nonesense84/VID_Doppelschaft/Dokumente/Rückansicht.png

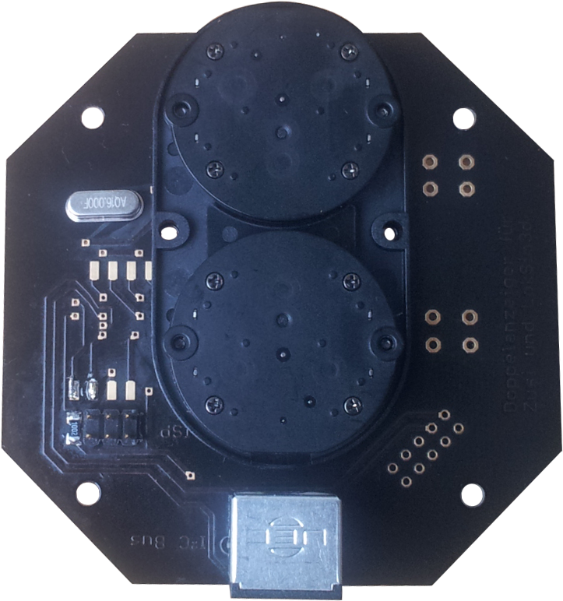
Dokumente/Rückansicht.png
