nonesense84/VID_Doppelschaft/Dokumente/Vorderansicht.png

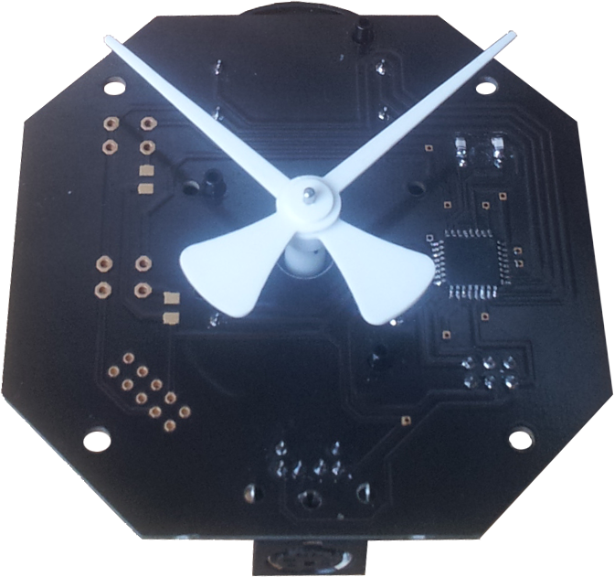
Dokumente/Vorderansicht.png
