nonesense84/VID_Doppelschaft/Dokumente/ProtokollExtrahiert.png

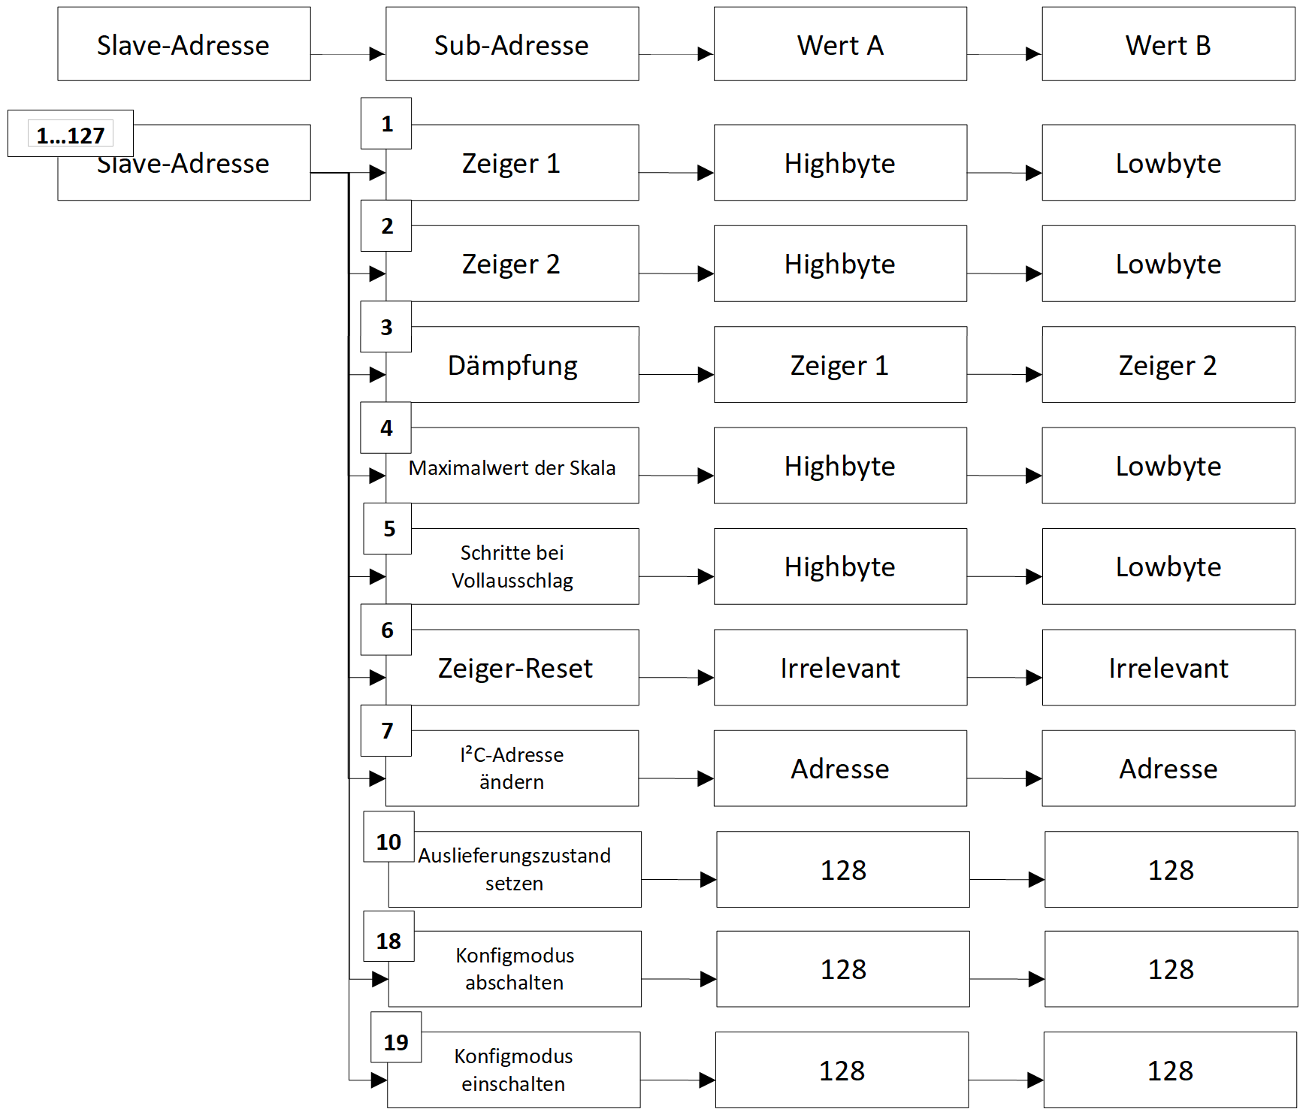
Dokumente/ProtokollExtrahiert.png
