nonesense84/VID_Doppelschaft/Dokumente/Schaltplan2.png

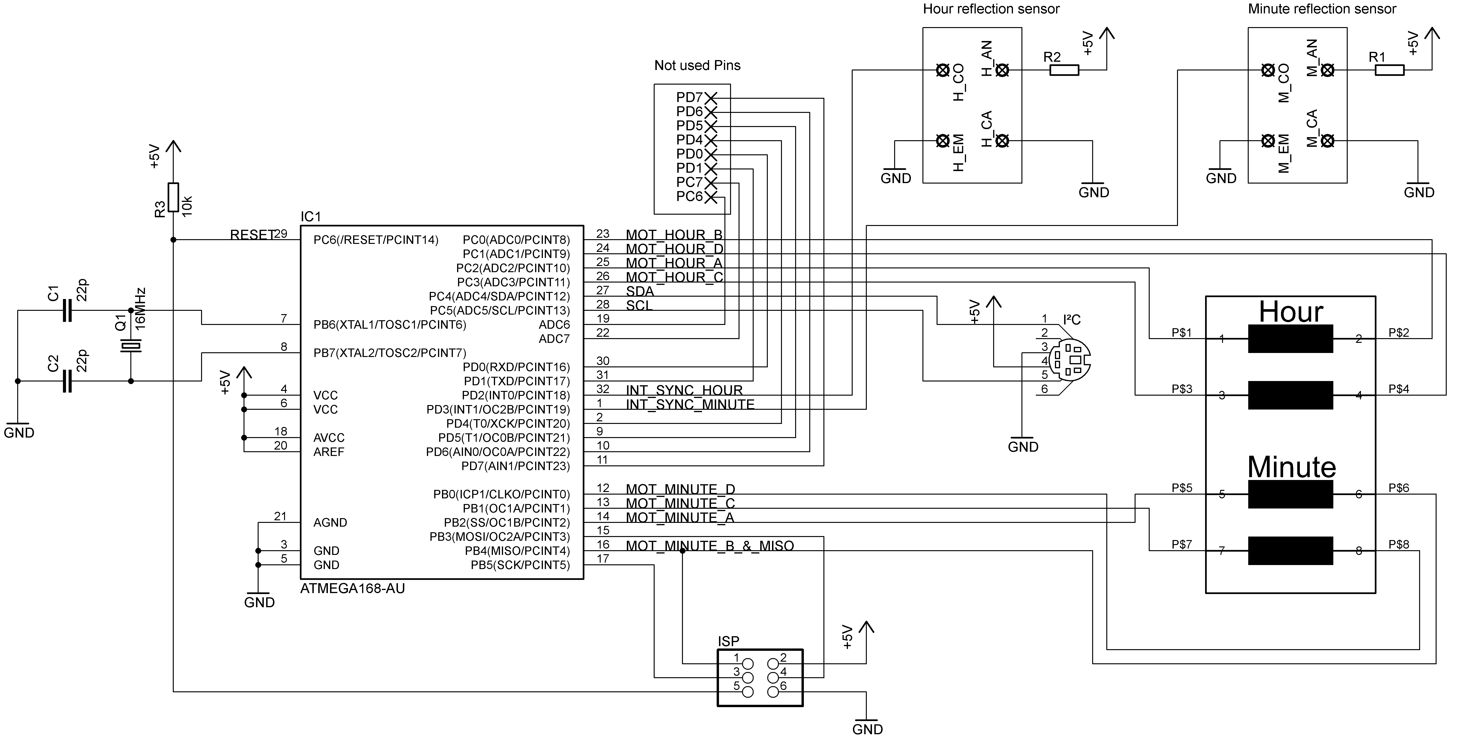
Dokumente/Schaltplan2.png
