nonesense84/VID_Doppelschaft/Dokumente/Schaltplan.png

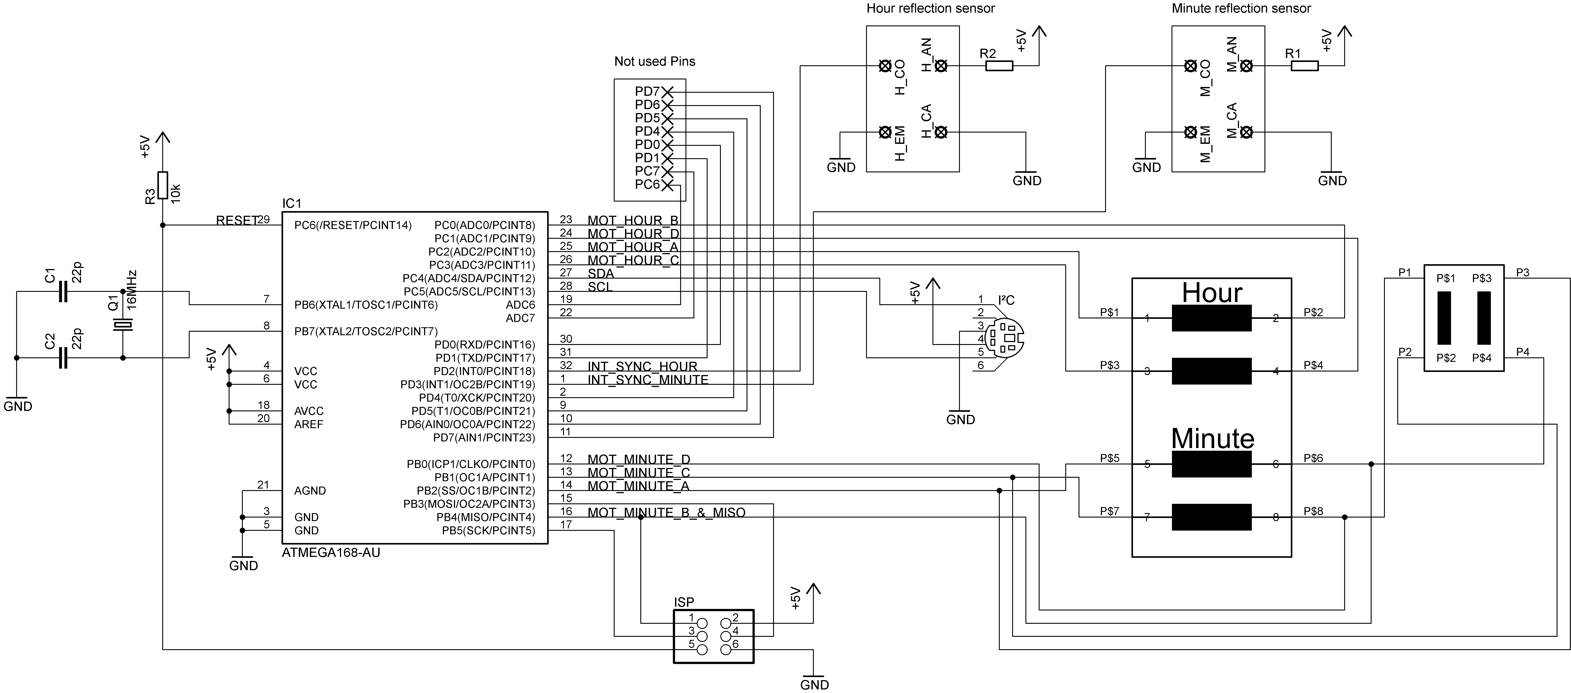
Dokumente/Schaltplan.png
