nonesense84/VID_Doppelschaft/(commit log)

2019-11-05 Added project files
    [dämpfung.xlsx]
2023-09-17 Switch off motor coils when reaching goal position.
